wingfieldjeff/sand_turner/cad/pin.stl

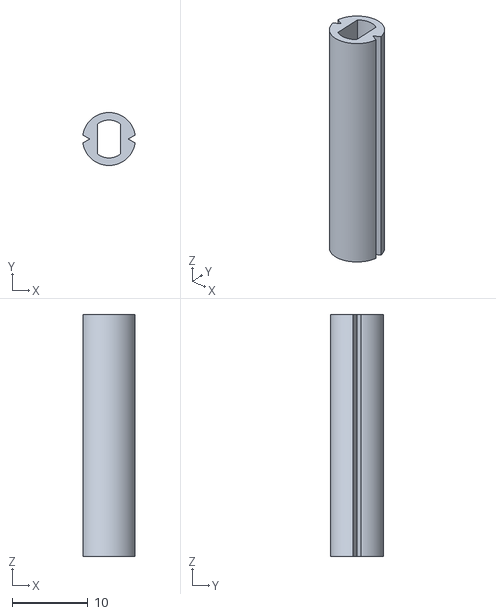
[picture p2: CAD file, 2025-02-24]
cad/pin.stl
6.93 x 7.00 x 32.0
