wingfieldjeff/sand_turner/cad/Shell Back.stl

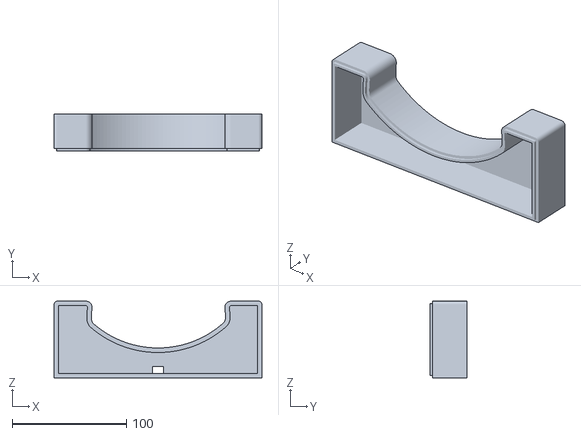
[picture p3: CAD file, 2025-02-24]
cad/Shell Back.stl
182.2 x 32.0 x 67.2
