wingfieldjeff/sand_turner/cad/roller.stl

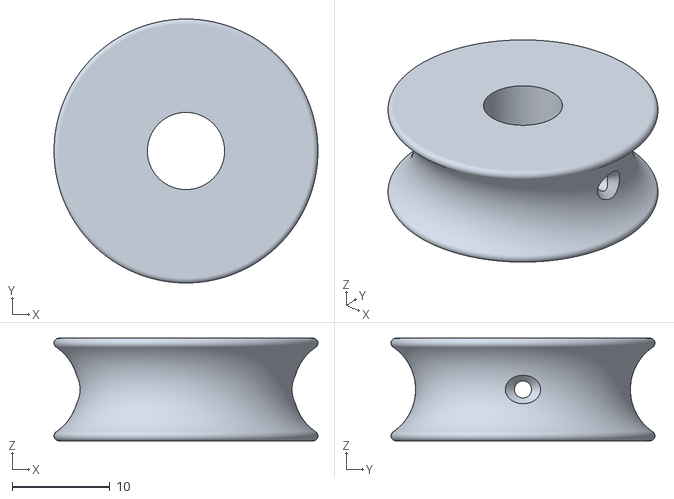
[picture p4: CAD file, 2025-02-24]
cad/roller.stl
27.0 x 27.0 x 10.5
