wingfieldjeff/sand_turner/sand_disk.ino

#include <AccelStepper.h>

// Define step type and steps per revolution
#define FULLSTEP 4
#define STEP_PER_REVOLUTION 2048

// Define step counts for 90 to 270 degrees
#define MIN_STEPS 3800   // 90 degrees
#define MAX_STEPS 11400  // 270 degrees
#define STEPS_TO_DEGREES (180.0 / 7600.0) // Convert steps to degrees

AccelStepper stepper_1(FULLSTEP, 11, 9, 10, 8);

// Define the LED pin (PWM-enabled pin)
#define LED_PIN 6

// Direction toggle variable
bool directionForward = true;

// Define brightness levels
#define BRIGHTNESS_MIN 64  // 25% brightness
#define BRIGHTNESS_MAX 255 // 100% brightness
#define BRIGHTNESS_STEP 5  // Smoothness step size

void setup() {
  Serial.begin(9600);

  // Configure stepper_1 with faster speed and acceleration
  stepper_1.setMaxSpeed(600.0);   // Max speed (steps per second)
  stepper_1.setAcceleration(500.0); // Acceleration (steps per second squared)
  stepper_1.setSpeed(100);         // Initial speed
  stepper_1.setCurrentPosition(0); // Set starting position to 0

  // Initialize the LED pin
  pinMode(LED_PIN, OUTPUT);
  analogWrite(LED_PIN, BRIGHTNESS_MIN); // Set LED to 25% brightness initially
}

void smoothTransition(int fromBrightness, int toBrightness) {
  if (fromBrightness < toBrightness) {
    // Gradually increase brightness
    for (int brightness = fromBrightness; brightness <= toBrightness; brightness += BRIGHTNESS_STEP) {
      analogWrite(LED_PIN, brightness);
      delay(10); // Adjust delay for smoother or faster transitions
    }
  } else {
    // Gradually decrease brightness
    for (int brightness = fromBrightness; brightness >= toBrightness; brightness -= BRIGHTNESS_STEP) {
      analogWrite(LED_PIN, brightness);
      delay(10); // Adjust delay for smoother or faster transitions
    }
  }
}

void loop() {
  // Randomize the number of steps for the rotation (90 to 270 degrees)
  long randomSteps = random(MIN_STEPS, MAX_STEPS + 1); // +1 to include MAX_STEPS in range

  // Adjust direction based on toggle
  if (!directionForward) {
    randomSteps = -randomSteps; // Make the steps negative for reverse direction
  }

  // Calculate the degrees rotated
  float rotationDegrees = abs(randomSteps) * STEPS_TO_DEGREES;

  // Calculate the proportional wait time in milliseconds
  long waitTime = rotationDegrees * 666.67; // Degrees-to-ms conversion (1° -> ~666.67 ms)

  // Smoothly increase LED brightness to 100% during rotation
  smoothTransition(BRIGHTNESS_MIN, BRIGHTNESS_MAX);

  // Rotate stepper_1
  stepper_1.enableOutputs();
  stepper_1.move(randomSteps); // Use move() for relative movement
  while (stepper_1.distanceToGo() != 0) {
    stepper_1.run();
  }

  // Smoothly decrease LED brightness back to 25% after rotation
  smoothTransition(BRIGHTNESS_MAX, BRIGHTNESS_MIN);

  Serial.print(F("Stepper_1 rotated by "));
  Serial.print(abs(randomSteps)); // Display positive value for steps
  Serial.print(F(" steps (~"));
  Serial.print(rotationDegrees); // Display rotation in degrees
  Serial.print(F(" degrees). Waiting for "));
  Serial.print(waitTime / 1000); // Display wait time in seconds
  Serial.println(F(" seconds."));

  // Toggle direction for the next rotation
  directionForward = !directionForward;

  // Wait proportional to the rotation
  stepper_1.disableOutputs();
  delay(waitTime); // Proportional wait time
}
